favallone20/Sensori_Project/Fritzing Scheme/Simulazione onde sinusoidali.jpg

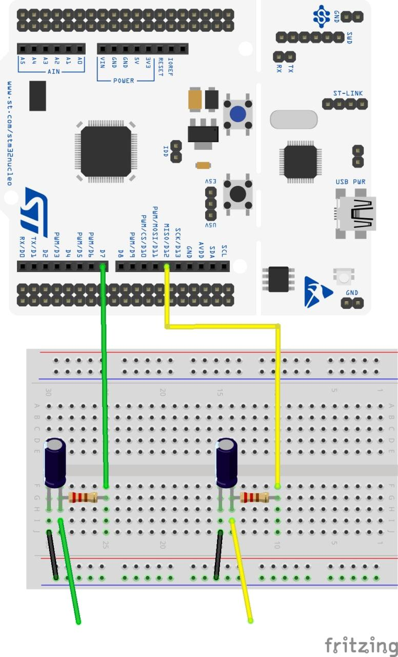
Fritzing Scheme/Simulazione onde sinusoidali.jpg
