favallone20/Sensori_Project/README.md

# Progetto Sensori e Attuatori
## Smart meter
### Gruppo:
* Francesco Avallone: f.avallone20@studenti.unisa.it - 0622701488
* Lorenzo Pagliara l.pagliara5@studenti.unisa.it - 0622701576
