favallone20/Sensori_Project/Report.pdf

## UNIVERSITA DEGLI STUDI DI SALERNO ´

Dipartimento di ingegneria dell’informazione ed elettrica e matematica applicata

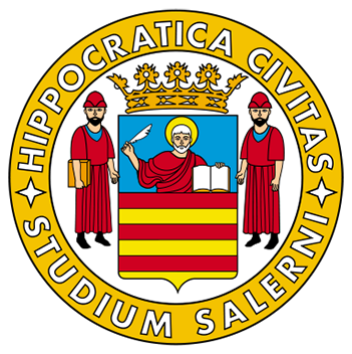
[picture p2: figure]

# Report Sensori e Attuatori

# Progetto smart meter

Docenti: | Giovanni Petrone - gpetrone@unisa.it
| Patrizia Lamberti - plamberti@unisa.it

Gruppo:
Lorenzo Pagliara | 0622701576 - l.pagliara5@studenti.unisa.it
Francesco Avallone | 0622701488 - f.avallone20@studenti.unisa.it

Anno Accademico 2021-2022

## Indice

1 Introduzione | 2
2 Circuito di interfacciamento | 2
3 Schema elettrico smart meter | 4
4 Simulazione sorgente delle grandezze elettriche | 5

### 5 Acquisizione delle grandezze elettriche e preelaborazione ango-

lo di fase | 6
6 Elaborazione dei dati mediante Raspberry | 6
7 Analisi e calcolo delle incertezze | 7

7.3 Calcolo dell’incertezza per l’angolo di sfasamento fra tensione e

8 Visualizzazione grandezze elettriche e archiviazione | 10
9 Codice | 10

1

## 1 Introduzione

Il progetto si propone di sviluppare un sistema di misura delle grandezze elettriche su una linea AC per il monitoraggio dei consumi energetici di un’utenza residenziale.

Per il perseguimento di tale obiettivo, sono state utilizzate due schede differenti:

1. STM32 Nucleo F401RE: dispositivo adottato per il campionamento dei segnali di tensione e corrente, provenienti da un circuito di interfacciamento (composto da sensori di tensione e corrente), e per la stima dell’angolo di sfasamento fra le due sinusoidi;
2. Raspberry Pi 3B+: dispositivo adottato per l’elaborazione dei dati acquisiti dalla scheda STM32 e per la stima dei consumi energetici.

L’interfacciamento fra le due schede `e stato definito mediante una comunicazione seriale, attraverso il protocollo USART, gestita direttamente dalla Raspberry la quale, con un opportuno segnale, richiede alla STM32 di campionare nuovi dati dalla sorgente elettrica per poi poterli elaborare.

## 2 Circuito di interfacciamento

### 2.1 Sensore di Corrente (ZMCT103C)

Per la lettura del segnale di corrente `e stato utilizzato un sensore open loop basato sull’effetto Hall.

Un sensore di questo tipo si basa sul principio che le cariche elettriche dei materiali semiconduttori costitutivi del sensore, se soggette ad un campo magnetico, generato ad esempio da un filo percorso da corrente, si distribuiscono lungo le estremit`a del materiale, per effetto della forza di Lorentz, generando una tensione di uscita. Tale tensione `e caratterizzata da un ordine di grandezza piuttosto piccolo, anche quando il sensore `e soggetto ad un forte campo magnetico esterno. Pertanto, la maggior parte dei sensori a effetto Hall disponibili in commercio sono costruiti con un amplificatore di tensione integrato e regolatori di tensione per migliorare la sensibilit`a del sensore e l’ampiezza della tensione di uscita.

Il sensore utilizzato `e un micro trasformatore di corrente in grado di generare in uscita una tensione pari a:

V =

R
1000

I

2

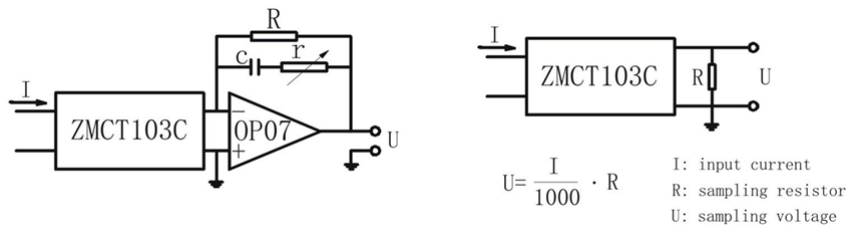
[picture p3: figure]

Figura 1: Schema ZMCT103C

Il sensore `e in grado di misurare correnti in modulo fino a 5A con accuratezza del 2% per valori di resistenza di campionamento minori di 10Ω. Il sensore in questione ha una resistenza di 1Ω, generando un rapporto tra corrente e tensione di 1 a 1000.

### 2.2 Sensore di Tensione (ZMPT101B)

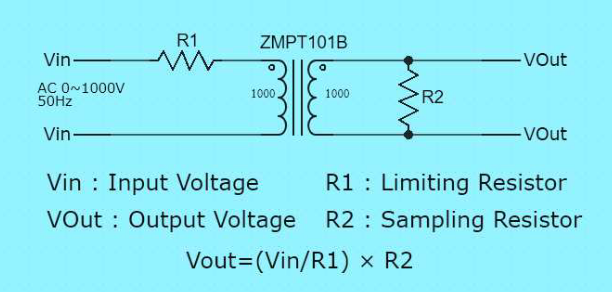
[picture p4: figure]

Figura 2: Schema ZMPT101

Il sensore di tensione ZMPT101B, basato sul principio di funzionamento del trasformatore, riesce a misurare segnali di tensione compresi fra i 0 e i 1000V . Nell’ottica della corrente, questo `e un trasformatore di corrente di 2mA:2mA. La resistenza R1 `e scelta in modo che la corrente sulla linea non superi i 2mA, sebbene possano essere trattate correnti fino a 10mA, cosi da mantenere una curva caratteristica lineare. D’altro canto, la resistenza R2 viene scelta in base alla Vout desiderata da cui ne consegue:

R2 =

Voutmax

Vin

R1

3

## 3 Schema elettrico smart meter

Il sistema di misura delle grandezze elettriche `e composto principalmente da due schede opportunamente interconnesse (come mostrato in Figura 3):

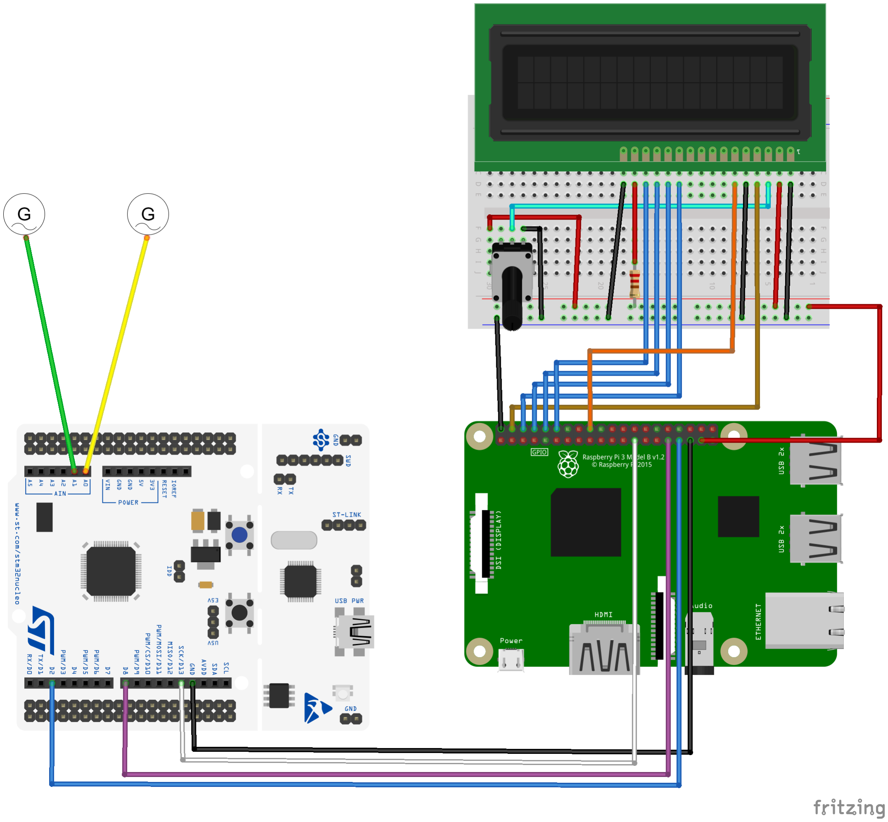
[picture p5: figure]

Figura 3: Schema elettrico smart meter

- STM32: adoperata principalmente per l’acquisizione e la digitalizzazione dei segnali analogici, in ingresso al sistema, mediante l’utilizzo dell’ADC integrato in quest’ultima.
- Raspberry: adoperata principalmente per l’elaborazione dei dati e per fornire in output le varie grandezze elettriche richieste analizzabili mediante un sistema di archiviazione dati o dal vivo mediante LCD.

4

## 4 Simulazione sorgente delle grandezze elettriche

In assenza di sensori collegati all’impianto elettrico, le sinusoidi della tensione e della corrente sono state simulate utilizzando una scheda STM32 aggiuntiva. Lo schema elettrico per la generazione dei segnali sinusoidali `e mostrato in Figura 4.

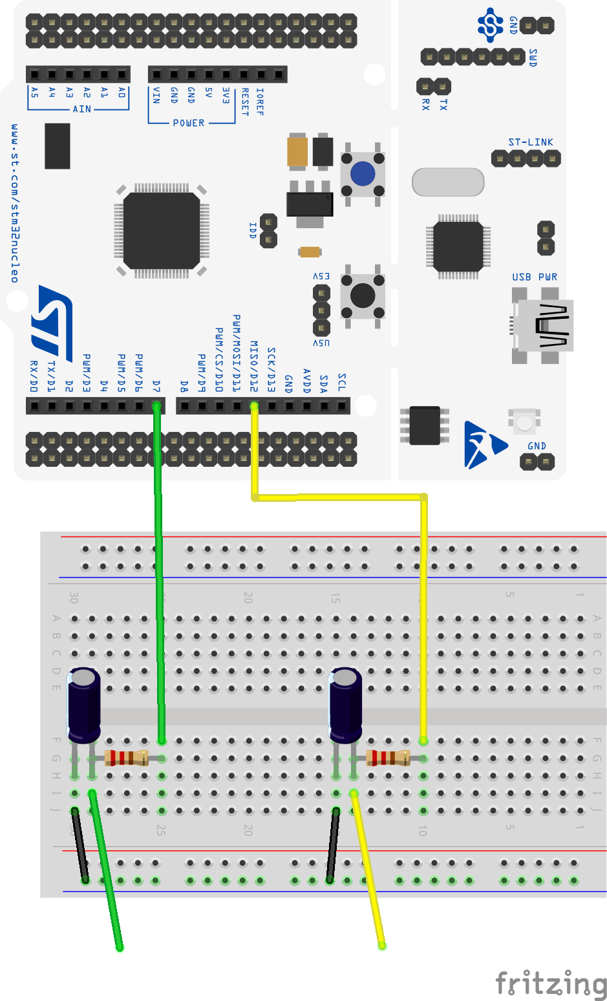
[picture p6: figure]

Figura 4: Schema di generazione sinusoidi.

Sulla STM32 sono stati settati due timer in grado di generare due segnali PWM, il cui duty cycle viene modificato sulla base dei valori assunti dal seno al variare degli angoli da 0 a 2π. I valori iniziali delle funzioni sono stati scelti in modo tale da generare due sinusoidi sfasate di π/2. In accordo a ci`o che avviene con la rete elettrica, la sinusoide in anticipo `e la sinusoide relativa alla tensione, mentre l’altra sinusoide, in ritardo, `e la sinusoide relativa alla corrente.

L’effettiva generazione della sinusoide avviene facendo passare il segnale PWM attraverso un filto passa basso, realizzato mediante una serie RC, con frequenza di taglio pari a:

5

ft =

1
2πRC =

1
2π · 330 · 6.7 × 10⁻⁶

≈ 70Hz

Il filtro ha il compito di computare il valor medio del segnale PWM e generare cos`ı un’onda continua.

## 5 Acquisizione delle grandezze elettriche e preelaborazione angolo di fase

Come gi`a detto in precedenza la scheda STM32 si occupa dell’acquisizione delle grandezze in ingresso mediante l’ADC integrato. Tale ADC `e unipolare, con tensione minima pari a 0V e tensione di riferimento pari a 3.3V , concordi con i valori di uscita delle tensioni dei due sensori, motivo per cui non `e stato introdotto alcun circuito di condizionamento.

L’ADC `e stato configurato in modo tale da avere un periodo di campionamento di 95µs, che nel periodo delle grandezze sinusoidali di 20ms, consente di acquisire all’incirca 210 campioni e con modalit`a di accesso in DMA, in modo tale da ridurre il carico della CPU.

Ottenuti i campioni di entrambe le sinusoidi `e stata effettuata una stima dell’angolo di sfasamento tra le stesse, secondo la legge:

phase =

td ∗ 360
p
dove td `e la differenza tra il tempo impiegato dalla corrente e quello impiegato dalla tensione per annullarsi e p il periodo delle sinusoidi. Poich´e `e noto il periodo di campionamento, `e stato possibile calcolare questi due tempi semplicemente conoscendo l’indice del primo valore nullo di ciascun segnale e moltiplicandolo per tale periodo.

Tali informazioni sono state poi trasmesse alla Raspberry mediante protocollo seriale USART.

## 6 Elaborazione dei dati mediante Raspberry

Per una pi`u facile elaborazione dei dati e delle loro incertezze `e stata utilizzata una scheda Raspberry. Nel codice sviluppato `e prevista l’acquisizione di un intero periodo delle sinusoidi di tensione e di corrente, attraverso i cui campioni, vengono elaborate le grandezze elettriche di interesse, quali potenza attiva, reattiva, apparente e il fattore di potenza. Per ridurre al minimo gli errori e aumentare l’accuratezza delle misurazioni `e stata prevista l’acquisizione di pi`u periodi, il cui numero `e definito mediante la variabile REP ET IT ION, prima di fornire l’output mediato all’utente.

6

In questa fase il Raspberry abilita la lettura dei segnali sulla STM32, alzando un pin di output collegato ad uno di input sull’altra scheda, e si mette in ascolto dei campioni. Prima di effettuare le elaborazioni, la scheda si occupa di normalizzare il valore dell’angolo di fase ricevuto. Di fatti, potrebbe succedere che risulti un angolo di fase negativo anche con segnale di corrente in ritardo rispetto a quello di tensione. Ci`o dipende dal fatto che la lettura dei segnali pu`o avvenire in un istante arbitrario e quindi, nel calcolo dell’angolo di fase, potrebbero risultare valori negativi nella differenza temporale tra istante di annullamento della corrente e quello della tensione, semplicemente perch´e si inizia a leggere da valori in cui la tensione gi`a si `e annullata e la corrente non ancora.

Ottenuto lo sfasamento φ si procede poi con il calcolo delle grandezze di interesse, secondo le formule:

Pavg =

VMAXIMAX
2

cos φ

Papp =

VMAXIMAX
2

Q =

VMAXIMAX
2

sin φ

cos φ =

Pavg

Papp

## 7 Analisi e calcolo delle incertezze

Secondo la teoria della misurazione, l’errore di una grandezza misurata `e la differenza fra il valore veritiero e il valore misurato. Sebbene questa terminologia viene utilizzata in molti contesti, nella teoria delle misurazioni non si conosce il valore ”vero” di una misura e quindi `e difficile identificare il conseguente errore. Per tale motivazione, si introduce il concetto di incertezza.
Nel caso dell’incertezza non esiste un unico valore vero, ma un insieme di valori veri, sebbene anche questi non conoscibili. In particolare, si fa riferimento all’incertezza standard ovvero l’incertezza del risultato di una misurazione espressa come deviazione standard e si indica solitamente con u.

### 7.1 Legge di propagazione

Nel caso delle misure indirette, come per il calcolo della potenza in questo progetto, l’incertezza della misura si calcola mediante la legge di propagazione delle incertezze:

u

2

(y) = X

N

i=1

∂F
∂xi

2
u

2
(xi) + 2

N

X⁻¹

i=1

N

X⁻¹

j=i+1

∂F
∂xi

∂F
∂xj
u(xi

, xj )

7

nell’ipotesi in cui la stima della covarianza tra xi e xj `e nulla allora u(xi

, xj )
risulta essere pari a 0 e l’equazione precedente si semplifica in:

u

2

(y) = X

N

i=1

∂F
∂xi

2
u

2
(xi)

### 7.2 Calcolo dell’incertezza per tensione e corrente

Figura 5: Catena di misura

Per misurare tensione/corrente bisogna attraversare vari elementi nella catena di misurazione prima che il valore misurato venga convertito in digitale. Per tale motivo, nel calcolare l’incertezza complessiva della tensione e della corrente, bisogna considerare le incertezze di tutti gli stadi e la propagazione di queste ultime lungo tutta la catena di misurazione:
- sensore di corrente e tensione: si considera la precisione dei due sensori pari al 0.2% (datasheet sensore di tensione, (http://5nrorwxhmqqijik.leadongcdn.com/attachment/kjilKBmoioSRqlkqjoipSR7ww7fgzb73m/ZMPT101B-specification.pdf) datasheet sensore di corrente); (https://datasheetspdf.com/pdf-file/1408475/ZeMing/ZMCT103C/1)
- circuiteria di interfacciamento: si suppone che la precisione della circuiteria di interfacciamento dei due sensori sia pari al 1%;
- errore ADC: l’errore dell’adc `e pari a 0.5 ∗ Q dove Q =

(Vref −Vmin)
2n bit | =

3.3−0
2

12 = 0.805mV . Da ci`o ne consegue che, l’errore dell’adc `e pari a 0.402mV .

Avendo queste informazioni `e possibile definire le varie incertezze (dove v `e la tensione misurata):
- uADC = 0.402mV
- usensore = v ∗ 0.2%
- uinterfaccia = v ∗ 1%

Analogo discorso pu`o essere fatto per la corrente.
Come noto dalla teoria della legge di propagazione delle incertezze, l’incertezza complessiva `e:
- uv,i =

q
u

2
ADC + u

2
sensore + u

2
interfaccia
dove v e i sono tensione e corrente.

8

### 7.3 Calcolo dell’incertezza per l’angolo di sfasamento fra

tensione e corrente

Avendo adottato una procedura algoritmica per il calcolo dell’angolo di sfasamento, l’incertezza di quest’ultimo `e stata calcolata considerando pi`u misurazioni da cui `e stata ricavata la varianza sperimentale. Di conseguenza, l’incertezza uphase =

q
s

2
k

, dove s

2 `e la varianza sperimentale mentre k `e il numero di misurazioni effettuate. Analoga procedura `e stata adottata per il calcolo dell’incertezza del cos(φ). A run-time, queste incertezze vengono aggiornate considerando tutte le misurazioni effettuate dall’avvio del sistema.

### 7.4 Calcolo dell’incertezza della potenza

Come noto dalla teoria dell’elettrotecnica, la potenza si divide in potenza apparente, potenza attiva e potenza reattiva:

- Papp =
VMAXIMAX
2
- Pavg =
VMAXIMAX
2

cos φ

- Q =
VMAXIMAX
2

sin φ

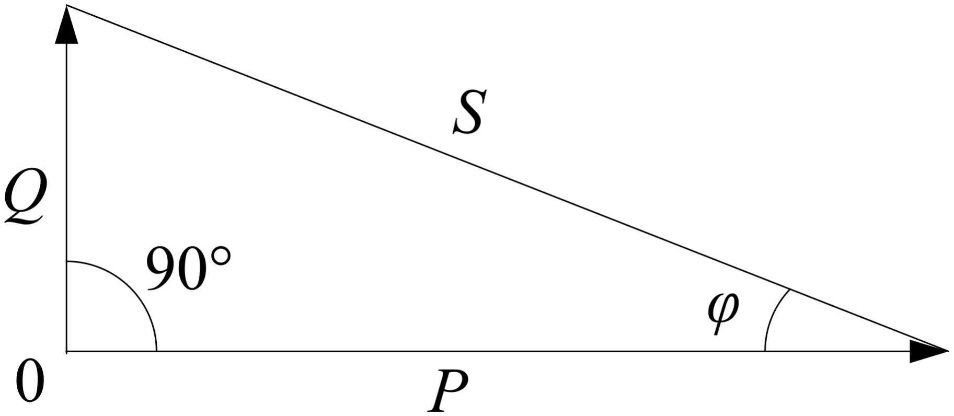
[picture p7: figure]

Figura 6: Grafico rappresentante il fattore di potenza

Da ci`o ne consegue, che le relative incertezze, in accordo alla legge di propagazione delle incertezze per misure indirette, sono:

- uapp =

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
- uactive =

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
cos(φ)
- ureactive =

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
sen(φ)

9

## 8 Visualizzazione grandezze elettriche e archiviazione

Le grandezze elettriche elaborate dalla Raspberry sono rese visibili all’utente sia mediante il terminale integrato della scheda, sia mediante un display LCD a cristalli liquidi (1602). Tale display `e in grado di visualizzare contemporaneamente 2 stringhe da 16 caratteri ciascuna, ricevute mediante 8 data bus, configurabili per lavorare in modalit`a 4 o 8 bit.

Le grandezze misurate sono poi archiviate in un file insieme alle informazioni relative alla data e ora della misura e all’intervallo di tempo, in ore, per cui `e stata fatta la stima.

## 9 Codice

Si rimanda al repository GitHub per ulteriori dettagli implementativi qui. (https://github.com/favallone20/Sensori_Project)

10
