favallone20/Sensori_Project/Fritzing Scheme/ProgettoSensori.png

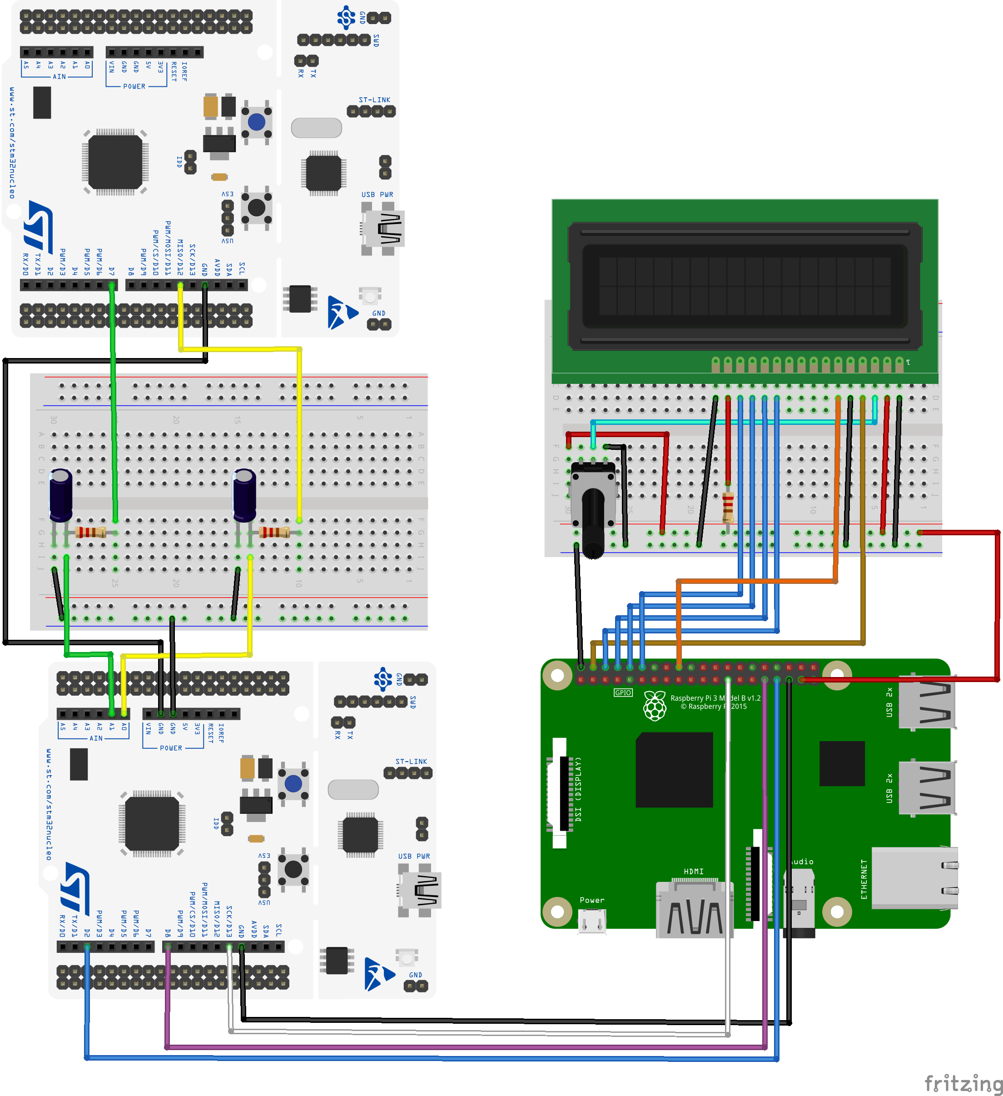
Fritzing Scheme/ProgettoSensori.png
