favallone20/Sensori_Project/(list of files, drawings)

Other design files:
Fritzing Scheme/ProgettoSensori.fzz
