favallone20/Sensori_Project/(commit log)

2022-02-26 project version 1.0
    [ProgettoSensori.fzz]
2022-02-28 images fritzing
    [ProgettoSensori.fzz]
2022-03-03 uncertainties on power and documentation
