favallone20/Sensori_Project/(notices)

Notices in the files:
Sin50Hz/Core/Src/main.c:
Copyright (c) 2021 STMicroelectronics.
All rights reserved.
This software is licensed under terms that can be found in the LICENSE file
